wsturner88/signalk-marine-gauge/enclosure/housing_bezel.png

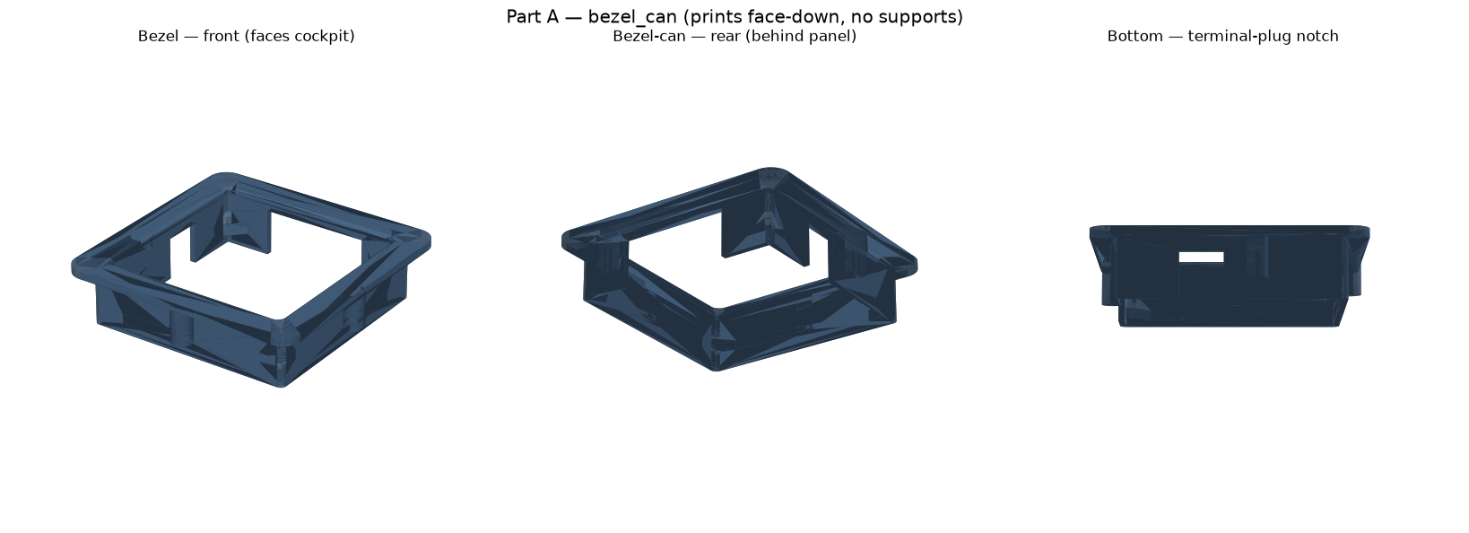
enclosure/housing_bezel.png
