wsturner88/signalk-marine-gauge/enclosure/housing_lid_frame.png

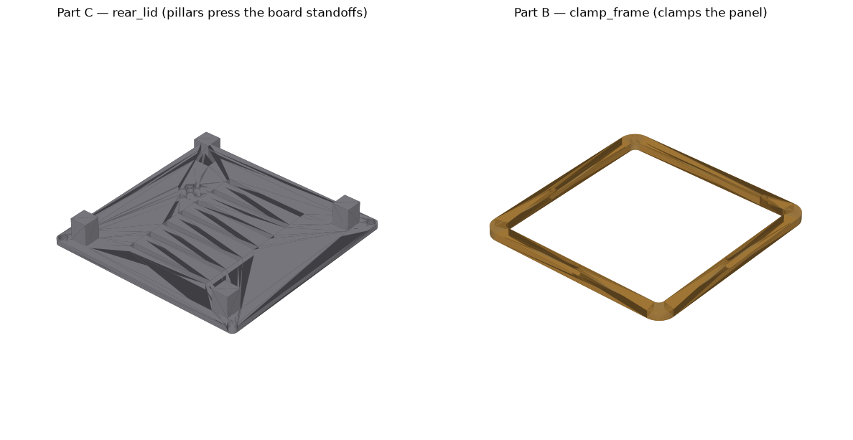
enclosure/housing_lid_frame.png
