wsturner88/signalk-marine-gauge/enclosure/pod_back.png

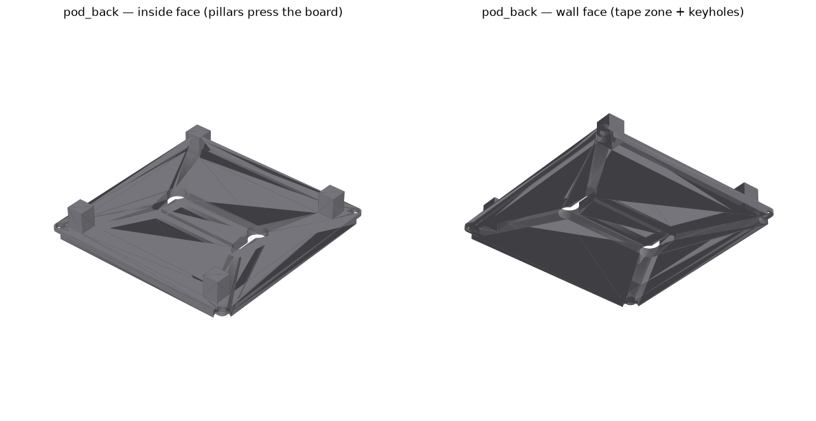
enclosure/pod_back.png
