wsturner88/signalk-marine-gauge/enclosure/pod_body.png

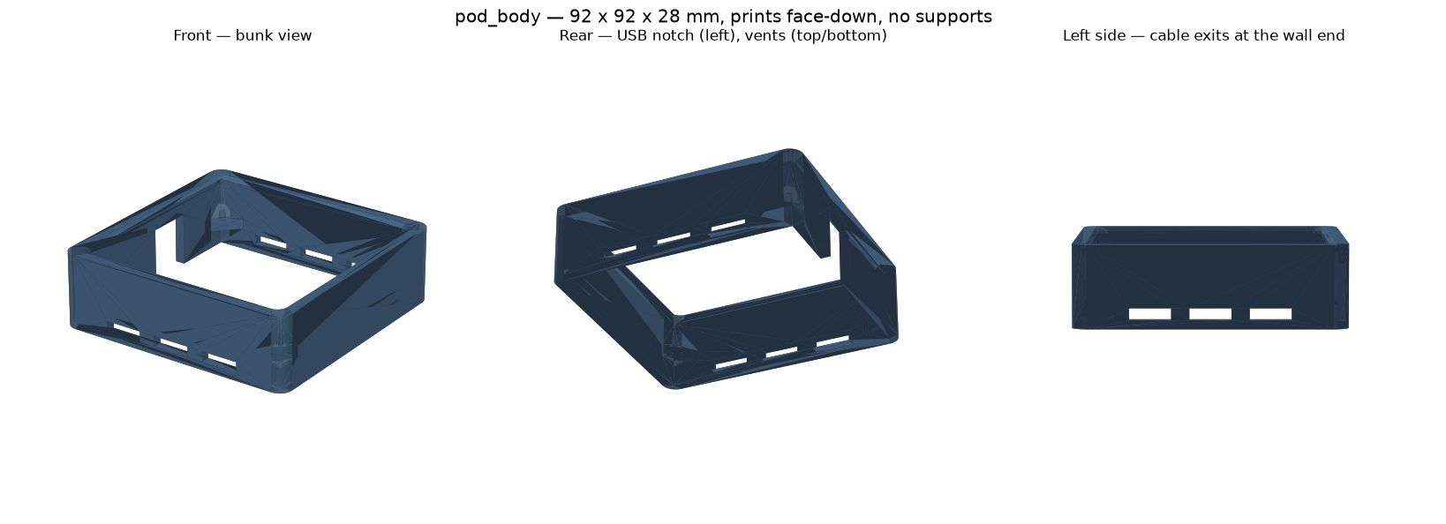
enclosure/pod_body.png
