wsturner88/signalk-marine-gauge/enclosure/export/pod_body.step

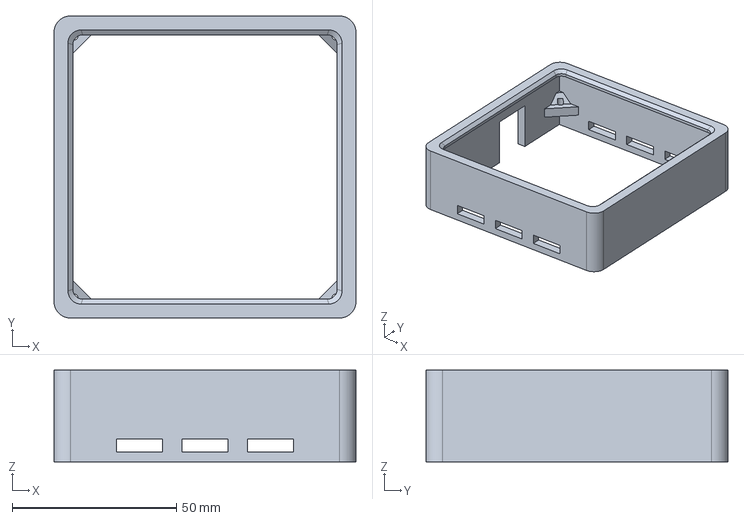
[picture p7: CAD file, 2026-07-05]
enclosure/export/pod_body.step
92.0 x 92.0 x 28.0 mm
