wsturner88/signalk-marine-gauge/enclosure/export/pod_back.step

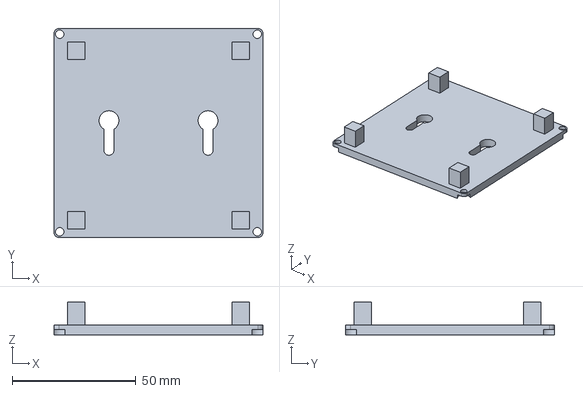
[picture p8: CAD file, 2026-07-05]
enclosure/export/pod_back.step
84.4 x 84.4 x 13.2 mm
