wsturner88/signalk-marine-gauge/enclosure/export/bezel_can.step

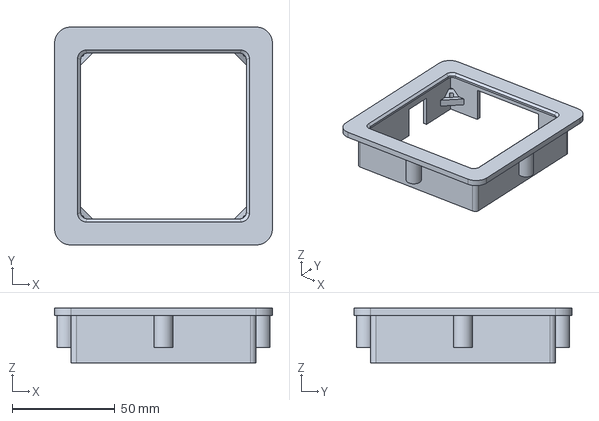
[picture p9: CAD file, 2026-07-05]
enclosure/export/bezel_can.step
106.0 x 106.0 x 26.5 mm
