wsturner88/signalk-marine-gauge/enclosure/export/clamp_frame.stl

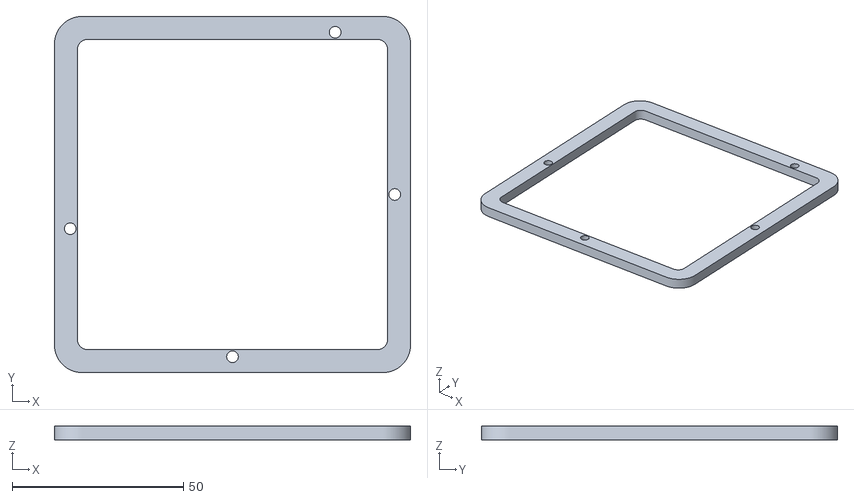
[picture p10: CAD file, 2026-07-05]
enclosure/export/clamp_frame.stl
104.0 x 104.0 x 4.00
