wsturner88/signalk-marine-gauge/(list of files, cad)

Other CAD files:
enclosure/export/pod_back.stl
enclosure/export/pod_body.stl
