wsturner88/signalk-marine-gauge/firmware/src/app/montserrat_150.c

/*******************************************************************************
 * Size: 150 px
 * Bpp: 4
 * Opts: --font vendor/waveshare-demo/examples/Arduino-v3.3.2/libraries/lvgl/scripts/built_in_font/Montserrat-Medium.ttf --size 150 --bpp 4 --format lvgl --symbols 0123456789.- --no-compress --force-fast-kern-format -o firmware/src/app/montserrat_150.c
 ******************************************************************************/

#ifdef LV_LVGL_H_INCLUDE_SIMPLE
#include "lvgl.h"
#else
#include "lvgl/lvgl.h"
#endif

#ifndef MONTSERRAT_150
#define MONTSERRAT_150 1
#endif

#if MONTSERRAT_150

/*-----------------
 *    BITMAPS
 *----------------*/

/*Store the image of the glyphs*/
static LV_ATTRIBUTE_LARGE_CONST const uint8_t glyph_bitmap[] = {
    /* U+002D "-" */
    0x26, 0x66, 0x66, 0x66, 0x66, 0x66, 0x66, 0x66,
    0x66, 0x66, 0x66, 0x66, 0x66, 0x66, 0x66, 0x66,
    0x66, 0x66, 0x66, 0x66, 0x57, 0xff, 0xff, 0xff,
    0xff, 0xff, 0xff, 0xff, 0xff, 0xff, 0xff, 0xff,
    0xff, 0xff, 0xff, 0xff, 0xff, 0xff, 0xff, 0xff,
    0xfe, 0x7f, 0xff, 0xff, 0xff, 0xff, 0xff, 0xff,
    0xff, 0xff, 0xff, 0xff, 0xff, 0xff, 0xff, 0xff,
    0xff, 0xff, 0xff, 0xff, 0xff, 0xe7, 0xff, 0xff,
    0xff, 0xff, 0xff, 0xff, 0xff, 0xff, 0xff, 0xff,
    0xff, 0xff, 0xff, 0xff, 0xff, 0xff, 0xff, 0xff,
    0xff, 0xfe, 0x7f, 0xff, 0xff, 0xff, 0xff, 0xff,
    0xff, 0xff, 0xff, 0xff, 0xff, 0xff, 0xff, 0xff,
    0xff, 0xff, 0xff, 0xff, 0xff, 0xff, 0xe7, 0xff,
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
    0x0, 0x0, 0x0, 0x0, 0x0, 0x0, 0x0, 0x0,
    0x0, 0x0, 0x0, 0x0, 0x0, 0x1, 0xcf, 0xff,
    0xff, 0xff, 0xff, 0xff, 0xff, 0xff, 0xff, 0xff,
    0xff, 0xff, 0xff, 0xff, 0xff, 0xff, 0xff, 0xff,
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
};


/*---------------------
 *  GLYPH DESCRIPTION
 *--------------------*/

static const lv_font_fmt_txt_glyph_dsc_t glyph_dsc[] = {
    {.bitmap_index = 0, .adv_w = 0, .box_w = 0, .box_h = 0, .ofs_x = 0, .ofs_y = 0} /* id = 0 reserved */,
    {.bitmap_index = 0, .adv_w = 919, .box_w = 41, .box_h = 13, .ofs_x = 8, .ofs_y = 35},
    {.bitmap_index = 267, .adv_w = 545, .box_w = 21, .box_h = 21, .ofs_x = 6, .ofs_y = -1},
    {.bitmap_index = 488, .adv_w = 1601, .box_w = 86, .box_h = 107, .ofs_x = 7, .ofs_y = -1},
    {.bitmap_index = 5089, .adv_w = 888, .box_w = 39, .box_h = 106, .ofs_x = 1, .ofs_y = 0},
    {.bitmap_index = 7156, .adv_w = 1378, .box_w = 79, .box_h = 106, .ofs_x = 2, .ofs_y = 0},
    {.bitmap_index = 11343, .adv_w = 1373, .box_w = 80, .box_h = 106, .ofs_x = 0, .ofs_y = -1},
    {.bitmap_index = 15583, .adv_w = 1606, .box_w = 94, .box_h = 105, .ofs_x = 5, .ofs_y = 0},
    {.bitmap_index = 20518, .adv_w = 1378, .box_w = 79, .box_h = 106, .ofs_x = 2, .ofs_y = -1},
    {.bitmap_index = 24705, .adv_w = 1481, .box_w = 82, .box_h = 107, .ofs_x = 7, .ofs_y = -1},
    {.bitmap_index = 29092, .adv_w = 1435, .box_w = 80, .box_h = 106, .ofs_x = 4, .ofs_y = 0},
    {.bitmap_index = 33332, .adv_w = 1546, .box_w = 84, .box_h = 108, .ofs_x = 6, .ofs_y = -1},
    {.bitmap_index = 37868, .adv_w = 1481, .box_w = 82, .box_h = 108, .ofs_x = 4, .ofs_y = -1}
};

/*---------------------
 *  CHARACTER MAPPING
 *--------------------*/

static const uint8_t glyph_id_ofs_list_0[] = {
    0, 1, 0, 2, 3, 4, 5, 6,
    7, 8, 9, 10, 11
};

/*Collect the unicode lists and glyph_id offsets*/
static const lv_font_fmt_txt_cmap_t cmaps[] =
{
    {
        .range_start = 45, .range_length = 13, .glyph_id_start = 1,
        .unicode_list = NULL, .glyph_id_ofs_list = glyph_id_ofs_list_0, .list_length = 13, .type = LV_FONT_FMT_TXT_CMAP_FORMAT0_FULL
    }
};

/*-----------------
 *    KERNING
 *----------------*/


/*Map glyph_ids to kern left classes*/
static const uint8_t kern_left_class_mapping[] =
{
    0, 1, 2, 3, 0, 4, 5, 6,
    7, 8, 9, 10, 3
};

/*Map glyph_ids to kern right classes*/
static const uint8_t kern_right_class_mapping[] =
{
    0, 1, 2, 3, 4, 5, 6, 7,
    8, 3, 9, 10, 11
};

/*Kern values between classes*/
static const int8_t kern_class_values[] =
{
    5, -13, 13, -33, -24, -37, 13, 0,
    -18, 0, 0, -13, 0, -22, -24, 18,
    18, -16, 0, -24, 18, 0, 13, -22,
    0, -5, -5, -18, 0, 0, -13, 0,
    0, -13, 18, -5, 0, 0, 0, -35,
    0, -5, 0, 0, 0, 0, 0, 0,
    -9, -9, 0, -18, -22, 0, 0, 18,
    37, 0, -46, -5, -22, 0, -5, -86,
    18, -13, 0, 0, 0, 0, -9, -9,
    0, -9, -24, 0, 0, 9, 18, 0,
    0, 0, 0, 0, 0, -13, 0, 0,
    -91, -95, -37, 18, 0, -15, -119, -33,
    0, -33, 0, 0, 18, 0, 0, 0,
    0, 0, 0, 0, 0, 0
};


/*Collect the kern class' data in one place*/
static const lv_font_fmt_txt_kern_classes_t kern_classes =
{
    .class_pair_values   = kern_class_values,
    .left_class_mapping  = kern_left_class_mapping,
    .right_class_mapping = kern_right_class_mapping,
    .left_class_cnt      = 10,
    .right_class_cnt     = 11,
};

/*--------------------
 *  ALL CUSTOM DATA
 *--------------------*/

#if LVGL_VERSION_MAJOR == 8
/*Store all the custom data of the font*/
static  lv_font_fmt_txt_glyph_cache_t cache;
#endif

#if LVGL_VERSION_MAJOR >= 8
static const lv_font_fmt_txt_dsc_t font_dsc = {
#else
static lv_font_fmt_txt_dsc_t font_dsc = {
#endif
    .glyph_bitmap = glyph_bitmap,
    .glyph_dsc = glyph_dsc,
    .cmaps = cmaps,
    .kern_dsc = &kern_classes,
    .kern_scale = 21,
    .cmap_num = 1,
    .bpp = 4,
    .kern_classes = 1,
    .bitmap_format = 0,
#if LVGL_VERSION_MAJOR == 8
    .cache = &cache
#endif
};



/*-----------------
 *  PUBLIC FONT
 *----------------*/

/*Initialize a public general font descriptor*/
#if LVGL_VERSION_MAJOR >= 8
const lv_font_t montserrat_150 = {
#else
lv_font_t montserrat_150 = {
#endif
    .get_glyph_dsc = lv_font_get_glyph_dsc_fmt_txt,    /*Function pointer to get glyph's data*/
    .get_glyph_bitmap = lv_font_get_bitmap_fmt_txt,    /*Function pointer to get glyph's bitmap*/
    .line_height = 108,          /*The maximum line height required by the font*/
    .base_line = 1,             /*Baseline measured from the bottom of the line*/
#if !(LVGL_VERSION_MAJOR == 6 && LVGL_VERSION_MINOR == 0)
    .subpx = LV_FONT_SUBPX_NONE,
#endif
#if LV_VERSION_CHECK(7, 4, 0) || LVGL_VERSION_MAJOR >= 8
    .underline_position = -11,
    .underline_thickness = 8,
#endif
    .dsc = &font_dsc,          /*The custom font data. Will be accessed by `get_glyph_bitmap/dsc` */
#if LV_VERSION_CHECK(8, 2, 0) || LVGL_VERSION_MAJOR >= 9
    .fallback = NULL,
#endif
    .user_data = NULL,
};



#endif /*#if MONTSERRAT_150*/
