wsturner88/signalk-marine-gauge/(commit log)

2026-06-13 Working SignalK boat-health gauge on Waveshare ESP32-S3-Touch-LCD-4 (REV4)
    End-to-end bring-up on Bijoux (2026-06-13): panel + GT911 touch, WiFi join,
    live SignalK over WebSocket, LVGL boat-health text panel with unit conversion.
    Firmware (firmware/, PlatformIO + pioarduino core 3.3.2):
    - env:app - WiFi -> ws://192.168.8.96/signalk/v1/stream -> LVGL panel
    - env:display - Waveshare V4 LVGL widgets demo (panel/touch bring-up)
    - env:scan - I2C bus scanner (variant probe: TCA9554/CH422G @0x24, GT911
    @0x5D, RTC @0x51 on merged bus SDA15/SCL7)
    - env:silence - drives expander outputs low (buzzer/backlight diagnostics)
    Confirmed: ESP32-S3 N16R8, MAC 58:e6:c5:72:3b:c0, plain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
2026-06-13 Swipeable wind + boat-status gauges; fix constant buzzer tone
    UI: LVGL tileview, swipe between an apparent-wind dial (lv_meter needle +
    knots) and a boat-status page (battery/depth/speed/fuel/cabin/shore). GT911
    touch wired into an LVGL input device for swiping; page dots + status line.
    Buzzer fix: the constant tone was the onboard buzzer fed by a FLOATING
    expander pin. Waveshare's demo config (0x03=0x3A) leaves P1/P3/P4/P5 as inputs;
    one drove the buzzer. Setting config 0x03=0x00 (all outputs) + 0x01=0xFF drives
    every pin high -> backlight on, resets released, buzzer pin no longer floats =
    silent. Buzzer is active-low on P4/P5 -> reusable as the anchor/boundary alarm.
    Adds env:buzztest +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
2026-06-13 Wind redesign (boat image, rim arrow), 5 pages, big speed/depth font, beep test
    Wind page: smooth anti-aliased boat-bow image (top-center), wind indicator is now
    an arrow that clocks around the outer rim (clear of the readouts), compass labels
    pulled to the rim, big AWS below the boat. STW/TWS in corners; needle/arrow uses
    the 3s circular-smoothed angle.
    Speed/Depth page: ~150px digits (montserrat_150), positioned under the titles.
    Status page: battery, fuel, 3 fresh-water tanks (PORT/STBD/AFT), cabin.
    Power page: centered SoC, colored charge/discharge box, "AC SOURCE" card with
    friendly name + icon (Shore/Battery), color-coded.
    Footer: SignalK logo (recolored by SK status) + WiFi icon, gre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
2026-06-13 Beep diagnostic (drive-low + float), bb_invalidate_cache patch, handoff notes
    - main.cpp: boot fires a 2-beep A/B diagnostic (drive P4/P5 low, then float) to
    identify the buzzer trigger; TEST-page BEEP button uses drive-low. (Neither
    confirmed audible yet -> buzzer may be passive; see CLAUDE.md open issues.)
    - Patched vendored Arduino_ESP32RGBPanel.cpp bb_invalidate_cache=false->true to
    reduce the PSRAM-fb vertical offset (vendor/ is gitignored - documented in brief).
    - CLAUDE.md: full firmware status + open issues (RGB double-buffer/tearing,
    buzzer passive-vs-active, making the vendor patch persistent) for next session.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
2026-06-13 Fix boot vertical offset: one-shot esp_lcd_rgb_panel_restart()
    The RGB GDMA can start mid-frame at boot, leaving the image circularly
    shifted up by ~vsync-porch lines (top rows wrap to the bottom). Restart
    the panel transmission once at ~800ms to realign the scan-out DMA to
    line 0. Touches only the boot sequence — no change to the rendering path,
    buffer count, or bounce buffer.
    Requires a vendor getter (Arduino_ESP32RGBPanel::getPanelHandle) that is
    NOT committed because vendor/ is gitignored — see follow-up note.
2026-06-13 Wind: ~1s smoothing instead of ~3s; smooth AWS/TWS too
    Apparent wind angle felt laggy (EMA A=0.13 ≈ 3s time constant at the
    ~400ms update rate). Bump to A=0.4 ≈ 1s so the rim arrow tracks the wind
    in near-real-time. Also apply a matching ~1s EMA to apparent/true wind
    speed (previously raw/jumpy) so the numbers read steady but responsive.
2026-06-13 Fix display drift at the source (disable bounce buffer); raw wind speed
    Display: the periodic resync didn't actually correct the drift. Real cause
    was bounce-buffer ISR starvation under WiFi. Disabled the bounce buffer
    (vendor patch, documented in firmware/patches/) so the RGB DMA reads PSRAM
    directly — no refill ISR to starve. Reverted the periodic restart back to a
    single boot-time resync (the boot offset still needs that one kick).
    Confirmed stable on-device.
    Wind: show speed raw (no smoothing) so gusts read live without lag/clipped
    peaks; only the direction arrow stays ~1s-smoothed. Apparent wind sampled
    faster (250ms) to catch gusts.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
2026-06-14 Restore bounce buffer for reliable cold-boot; SYSTEM page; gusts; WIP buzzer
    Display: cold power-on was coming up black with the bounce buffer disabled
    (the drift fix). Reliable boot matters more for a mount-and-forget gauge, so
    restore the bounce buffer (vendor default). Boot offset stays fixed by the
    one-shot esp_lcd_rgb_panel_restart(). Known trade-off: image may drift under
    heavy WiFi again — to revisit with a deeper fix (e.g. core pinning) later.
    UI:
    - New SYSTEM page (last tile): WiFi + SignalK connection status cards.
    - Footer WiFi/SignalK icons removed (status now lives on the SYSTEM page).
    - 5-min and 1-hr true-wind gusts shown in the wind page's bottom corners.
    - Clean repaint s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
2026-06-14 Record full buzzer investigation; backlight-blink write test
    Document every buzzer test + confirmed hardware facts in
    firmware/docs/buzzer-investigation.md so dead ends aren't repeated:
    - Buzzer BEE_EN = EXIO6 = P5 = bit5 of TCA9554 @0x24 (bus 15/7); active buzzer,
    active-HIGH enable (Q1 SS8050, R18 4.7K pulldown). Confirmed via schematic.
    - I2C scan: only 0x24/0x51/0x5D on 15/7; nothing on 8/9; no 0x20.
    - Everything tried (drive hi/lo, toggle, freq sweep, float, cfg-toggle, P1/P3
    high) = silent. I2C register read-back is unreliable here.
    Current diagnostic (buzzDiag, auto-run ~3s + TEST button): blink backlight via
    P1 to prove expander writes work, then drive the buzzer on P5.
    Co-Auth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
2026-06-14 Buzzer WORKING: CH32V003 expander (not TCA9554) — correct init + bit6 beep
    Root cause found (credit: on-board research + Waveshare demo): the I2C expander
    @0x24 is a CH32V003 smart IO expander, NOT a TCA9554. Different register map:
    0x02 = direction (1=output), 0x03 = output (1=high), 0x04 = input, 0x05 = PWM.
    We had been driving it with TCA9554 semantics the whole time, which is why every
    buzzer attempt failed and why the expander init was subtly wrong.
    Fixes:
    - expanderInit(): write the PROVEN Waveshare-demo values 0x02=0xFF (all outputs),
    0x03=0x3A (working display/backlight state). Replaces the wrong TCA9554 writes.
    - buzzer(): bit 6 of the output reg, active-HIGH. silent=0x3A, be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
2026-06-14 Add board reference doc; mark buzzer SOLVED (CH32V003)
    - firmware/docs/BOARD_REFERENCE.md: self-contained "everything we've learned"
    for this board — power-cycle-after-flash gotcha, CH32V003 register map + init,
    buzzer (bit6), display/bounce-buffer setup, I2C map, touch, recovery checklist.
    - Mark buzzer-investigation.md SOLVED and point at the reference.
    - Update CLAUDE.md open issue #2 -> resolved.
2026-06-14 Board reference: add known-open display issues (offset, wind-page swipe)
2026-06-14 Boot offset: fire scan-out resync up to 4x in first ~4s (stable)
    A single 800ms esp_lcd_rgb_panel_restart() didn't clear the vertical offset on a
    true cold boot; repeating it a few times in the first few seconds does. Confirmed
    stable on-device (offset cleared, graphics clean).
2026-06-14 Add instant page-nav buttons (snappier than swipe) + short boot beep
    - On-screen discreet ◀ ▶ buttons flank the page dots; lv_obj_set_tile_id with
    LV_ANIM_OFF jumps instantly, skipping the heavy scroll-redraw of the wind page.
    Swipe kept as a fallback.
    - 150ms boot beep at end of setup() so power-up is audible.
2026-06-14 Replace TEST page with ANCHOR page (y2k-anchor-alarm) + drag buzzer alarm
    - New buildAnchor() page (tile 4): big state (NO ANCHOR / ANCHORED / WATCH /
    DRAGGING!), range vs max-radius (ft) + bar, and a "test alarm" button.
    - Subscribe to navigation.anchor.currentRadius, .maxRadius, and
    notifications.navigation.anchor (state). Parse in applyDelta.
    - loop() pulses the buzzer (~350ms on/off) on alarm/emergency state — non-blocking,
    sounds on any page. Removed the old buzzer TEST page/code.
2026-06-14 Anchor: use navigation.anchor.state (on/off) + derive drag from radius
    The y2k plugin exposes navigation.anchor.state ("on"/"off") for anchored-vs-not
    and currentRadius/maxRadius for the swing. Subscribe to .state; drive ANCHORED
    from it; derive DRAGGING from currentRadius > maxRadius (robust — confirmed these
    deltas stream reliably) OR a notification alarm/emergency. Buzzer alarm uses the
    same condition. Removed debug logging.
2026-07-03 Fix scan-out roll + replace tileview drag with flick gestures
    Roll (confirmed fixed on-boat): PCLK 12->10MHz for bounce-refill headroom;
    fbResync() helper fired at boot, on page-change settle, and every 2 min.
    Swipe: disable tileview finger-drag, page-change = LVGL flick gesture ->
    instant gotoTile. Wind page flick was dead because the meter kept the
    default SCROLLABLE flag (cards clear it) and claimed the drag; also pause
    data repaints while touched so compass redraws can't starve the gesture.
    Heartbeat now reports sk= status.
2026-07-03 Add WEATHER page: barometer arc + 3h trend + 24h chart + temp cards
    Pressure/humidity from the Cerbo CABIN Ruuvi (venus.28), freezer temp from
    the 'Freezer' sensor. On-device 10-min sampling into a 24h ring drives an
    lv_chart history and a 3h trend with marine coloring (>1 mb/3h change,
    >3 mb/3h falling = red). OUTSIDE card + environment.outside.temperature
    subscription are pre-wired for a future weather feed or outdoor sensor.
2026-07-03 Anchor page redesign: top-down swing plot + stats column
    lv_canvas (300x300 PSRAM) north-up plot: anchor cross at center, alarm ring
    (green/red), 15-min GPS trail (10s samples), boat dot + heading tick, wind
    arrow on the rim. Auto-zoom fits maxRadius/current swing. Stats column:
    range/max, wind + gust, depth, max swing this set. Status now includes
    NOT ANCHORED vs NO Y2K PLUGIN (seenY2k), y2k-anchor-alarm credit on page.
    Subscribes navigation.position + navigation.anchor.position (doubles).
2026-07-03 Display modes: DAY / NIGHT / SLEEP / AUTO with backlight PWM
    CH32V003 reg 0x05 backlight duty. Bottom-left button cycles modes (NVS-
    persisted). NIGHT = dim glow (12/255); SLEEP = backlight off, any touch
    lights it 20s (60s grace at boot); AUTO = day/night at civil twilight via
    NOAA solar elevation from GPS position + navigation.datetime. Any active
    alarm forces full brightness in every mode.
2026-07-03 Backlight dimming WORKING: CH32V003 0x05 duty is inverted; power-page TIME LEFT
    bltest saga findings (documented in BOARD_REFERENCE): reg 0x05 low=bright,
    255=off (recoverable), 0=TRAP (latches dead until power loss); output reg
    bit3=LCD reset (never toggle at runtime), backlight is not on the output reg.
    App maps brightness v -> reg max(8,255-v), never writes 0. Display modes
    DAY/NIGHT/SLEEP/AUTO now fully functional. New bltest env: white-screen +
    beep-counted register experiment tool. Power page: TIME LEFT (hours to
    empty from Victron timeRemaining, yellow <12h, red <4h).
2026-07-03 Move display-mode control to System page; defer NVS save (fixes mode-tap roll)
    The per-tap prefs.putUChar was a flash write, which stalls PSRAM and slips
    the RGB scan-out (roll + artifacts). Mode save is now deferred 4s after the
    last tap with an immediate fbResync after the commit. Global bottom-left
    button removed; System page gets a Display card (mode + description +
    CHANGE) alongside slimmed WiFi/SignalK cards.
2026-07-03 WiFi + SignalK onboarding: captive portal, QR setup page, mDNS discovery
    New portal.cpp: open AP Gauge-XXXX (AP_STA so scans still work), wildcard
    DNS captive portal, phone page with scanned-network list / password /
    SignalK auto-or-manual. Config lives in NVS; secrets.h is now only a
    first-boot dev seed. On-screen full-page setup UI with WIFI: QR code
    (LV_USE_QRCODE) and live status. SignalK host resolution moved to loop():
    manual host, else mDNS _signalk-http._tcp browse (gauge is gauge.local).
    Portal entry: no config, System-page SETUP button (two-tap confirm),
    finger held at power-on, or WiFi never up 45s after boot; auto-exits if
    the saved network comes back.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
2026-07-03 Factory-fresh behavior: secrets seed now opt-in (SEED_FROM_SECRETS); cfgv=2 wipe
    Out of the box, empty config boots straight into the onboarding portal —
    the product behavior. secrets.h auto-adopt is a dev-only build flag now.
2026-07-03 Anchor staleness watchdog + wider boot/event resync coverage
    Watchdog: anchored + no navigation.position/anchor.currentRadius for 30s
    -> yellow STALE status with live age, greyed swing plot with STALE DATA
    stamp, double-chirp every 30s (drag alarm takes priority); loop ticks the
    page so the age counts with zero incoming data; self-clears on resume.
    Roll fix round 3: boot resyncs now span ~16s (WiFi join + mDNS + WS
    subscription burst all land after the old 4s window), plus one-shot
    resyncs scheduled 1.5-2s after WiFi-connect and SK-connect events.
2026-07-03 Add SignalK-mirror deployment kit (Docker) for home/work gauges over Tailscale
    deploy/signalk-mirror: compose file (host networking for mDNS + tailnet
    reach) + README covering the upstream connection to openplot, mandatory
    subscription throttling (2-3 GB/mo vs 15-25 unthrottled on the boat's
    100 GB Starlink), chaining work off the home mirror, and gauge
    auto-discovery. Supersedes the original MQTT-bridge Phase 2 plan.
2026-07-03 Portal: stable AP — stop STA retries while in setup, gentle 1/min rejoin
    Failure-entered setup kept WiFi.begin hammering the saved SSID; on the
    shared ESP32 radio those scans drag the softAP across channels, so phones
    could see Gauge-XXXX but not stay associated (hit when the gauge moved
    off the boat network). STA is now always disconnected in portal mode,
    with one quiet ~8s rejoin attempt per minute so a returning network
    still auto-resumes.
2026-07-03 Portal: idle STA before the scan; never rejoin-retry while a phone is on the AP
    Moved-home failure path: the network scan ran during the bijoux retry
    storm (empty list), and the first gentle rejoin fired ~60s in — exactly
    while the user was on the page — hiccuping the AP (frozen/broken page).
    Scan now runs on an idle radio with one whiff-retry; background rejoin
    is gated on portalClients()==0 and resets its timer at portal entry.
2026-07-03 TODO: weather feed decided — signalk-virtual-weather-sensors + Open-Meteo (keyless, delta-native)
2026-07-05 Enclosure: parametric flush panel-mount housing (build123d) — STEP+STL, validated against Waveshare board STEP
2026-07-05 Enclosure: surface-mount pod variant (VHB tape / keyhole, no panel cutout) for the V-berth status display
2026-07-05 Pod v2: replace corner gussets (floating first layer) with wall-face teardrop bosses — truly support-free on FDM
